soysalper/METU-EE464-TermProject/EE 464 Hardware Project Final Report.docx

# EE 464

# Hardware Project

# Final Report

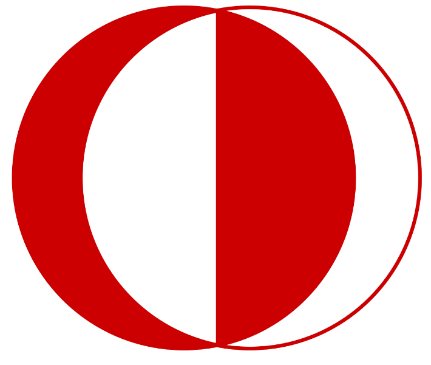
[picture p1: figure]

Team 5

Student 1 & ID: Alper Soysal & 2305324

Student 2 & ID: Hüsnü Oğuz Yorgancılar & 2305787

Student 3 & ID: Göktuğ Tonay & 2305506

# Introduction

In this report, we will explain the design procedure of the push pull converter for the METU EE 464 – Hardware Project. Basically, we will look at the circuit and magnetic design. Then, we will examine the simulation results. After that, we will talk about the implementation procedure. Finally, we will look at the test results of the implementation.

# Topology Selection

There are many topologies to design an isolated DC-DC converter such as flyback, forward, push pull etc. Each of them has some advantages and disadvantages. So, we want to select the topology as different from the other hardware project. As a result, we decided to design a “Push Pull Converter”.

Advantages

- Good transformer core utilization
- Easier to base drive (low side switching)
- Small Filter and Transformer
- Interleaved Structure

Disadvantages

- Voltage stress on the FET’s is twice the input voltage
- Asymmetric switch signals cause a flux walking in the core
- Number of the semiconductors are larger than the other topologies

# Magnetic Design

## Transformer Design

In order to determine the turn ratio of the transformer, we can look at the push pull converter voltage equation.

V_(out) =2*V_(in) *D*(N_2)/(N_1)

In the design requirements, we know that input voltage varies between the 24V and 48V. Also, push pull converter requires duty cycle which is smaller than the 0.5.

If we put a range for duty cycle such as 0.15 < D <0.3, we can find the necessary turn ratio

15=2*48*0.2*(N_2)/(N_1) =>(N_2)/(N_1)=1

Minimum number of turns can be determined as the flux density in the core cannot reach the saturation. So, minimum number of turns can be calculated as following formula.

(V_(input-max) *D_(maxi) *1/(f_s))/(2*B_(sat) *A_e)=N_1

Then, we can use the effective area of the core. Our first core decision is the TDK Electronics B66335G0000X187 magnetic core. Its effective cross-sectional area is 354 mm² .

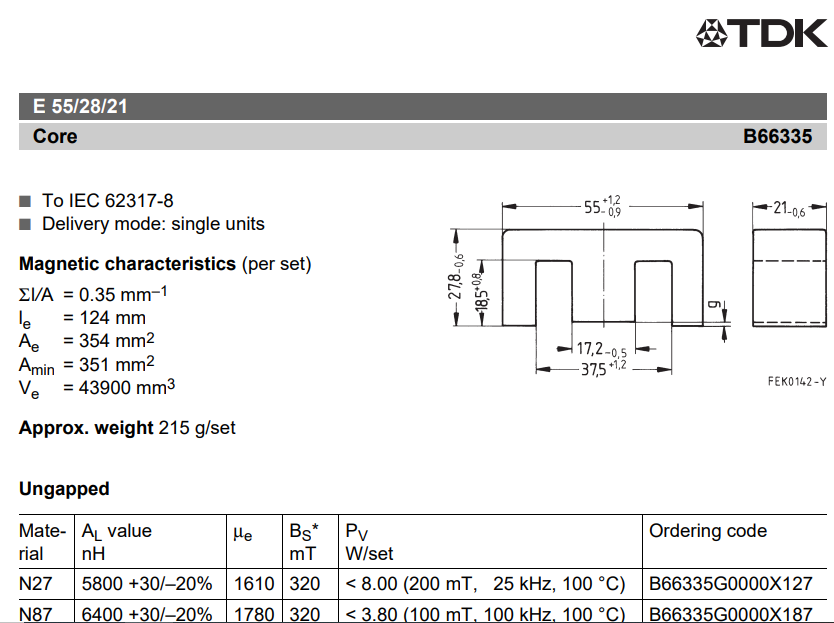
[picture p2: figure]
tablo içeren bir resim Açıklama otomatik olarak oluşturuldu
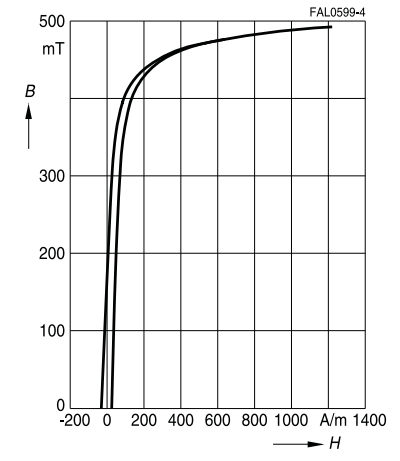
[picture p3: figure]

Maximum flux density varies depends on the material of the core. For a safety, we can select as maximum 0.2 T.

N_(1-min) =(48*0.3*1/(100k))/(2*0.2*354x10^(-6))≅1

In order to put a safety, number of turns can select as 4 turn primary and 4 turn secondary.

In the simulation, maximum current is 2.2 A for input, 3.3 A for the output. Also, our core has more window area. So, we decided to use directly a litz cable which has 3.14 mm^2 area which can carry nearly three or four times the expected currents. Then, when we calculate the fill factor, we obtained the following calculation

Fill Factor=((8+8)*3.14)/((10.15*18.5)*2)=%10

## Inductor Design

In the Push Pull topology, we need an inductor. We assumed that inductor current ripple is around %10 of the maximum output current.

Δi_L =3*0.1=0.3 A

Then, we can write the inductor voltage equation as:

V=L*(Δi)/(Δt)L=V*(Δt)/(Δi)=(((V_S *(N_S)/(N_P)-V_O )*(D/(f_s))))/(Δi)=(((48*1-15)*((0.3*2)/(100e3*2))))/0.3

=330 μH

# Simulation Results

In the simulation report, we simulated the circuit while N2/N/1=3/4. After changing that ratio to 4/4, we have updated the simulation results. Also, we have included all the nonidealities such as diode forward voltage, MOSFET RDS,ON, capacitor and inductor ESR values.

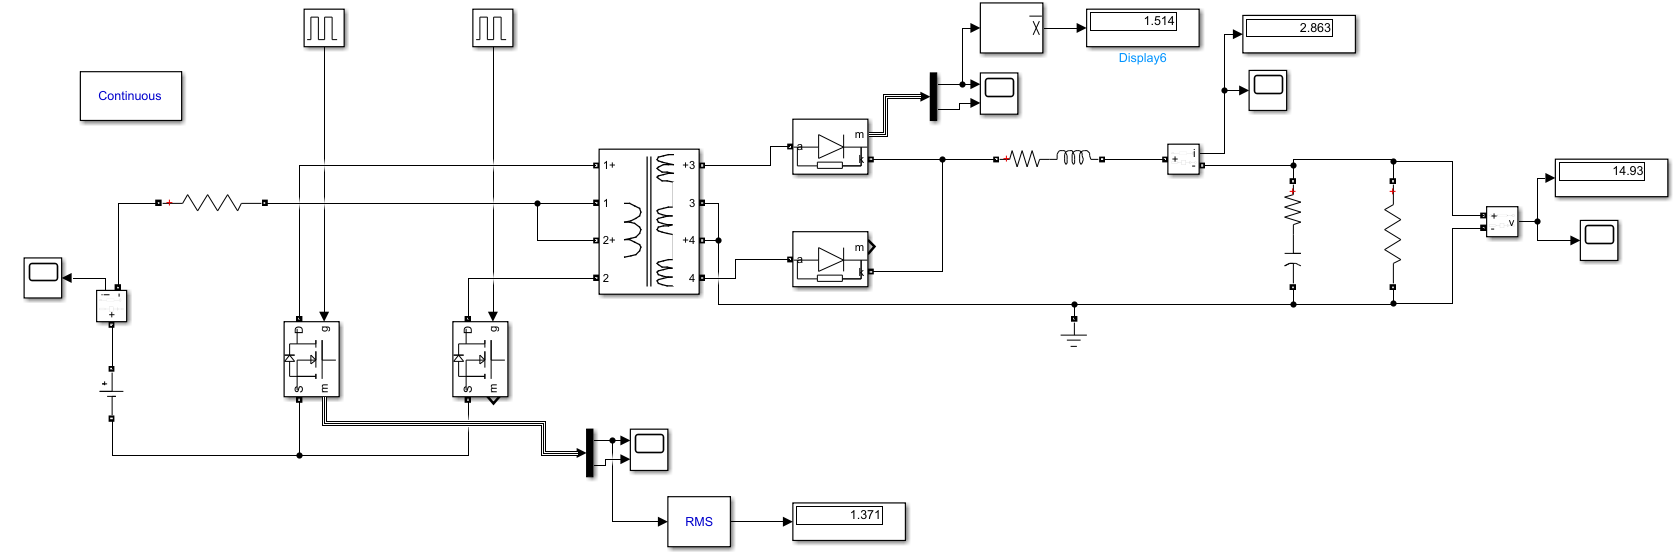
[picture p4: figure]

Figure-1: Simulation model of our circuit

When the input is 24V, with 0.44 duty cycle, simulation results including input current, output current & voltage, primary & secondary coil voltages, diode current & voltage, switch current & voltage are obtained as follows:

Figure-2: Output Voltage with 24V input

Figure-3: Output Current with 24V input

Figure-4: Switch current and voltage with 24V input

Figure-5: Diode current and voltage with 24V input

All those simulations are also done for 48V input, with a duty cycle of 0.16. Since we increased the inductance of the output inductor, we get less current ripple. On the other hand, due to the ESR of the output capacitors, we get a higher output voltage ripple around 200mV. Also, the diode maximum voltage is now doubled to 96V.

Figure-6: Output Voltage with 48V input

Figure-7: Output current with 48V input

Figure-8: Switch current and voltage with 48V input

Figure-9: Diode current and voltage with 48V input

# Component Selection

In a push-pull converter, we mainly need a controller, transistors for switching, transformer, diode for rectification and inductor for filtering. We already discussed about inductor and transformer in this report. We will start with the discussing about component selection with controller for our converter.

As already mentioned about in the topology selection part, push pull converter has some disadvantages. First and main one is, asymmetry due to manufacturing errors and tolerances, cause flux walking in the core. Flux walking can be defined as accumulation of the flux in the core due to non-zero net flux in a cycle. This non-zero net flux will be add up in the time and will cause saturation of the core. There will be constantly increasing DC component of the flux of the core. In the low frequency transformers like in the mains transformers, resistive components of the windings control this problem. However, in a high frequency transformer in our case, resistive component of the winding is not enough to solve. This means that in a realistic push-pull converter will create a non-zero net flux in the core every cycle which add up with the previous one. If we plot the flux in the core, it will look like it is walking or in a stair shape. To solve this problem, current control can be used. In current mode control, duty cycle of the switched will be controlled according to the current passing through each switch. Average or peak current can be used to control.

Due to that problem, our controller must have current mode control. With that input we searched for controllers and chose LM5030 as our controller.

LM5030:

Basic structure of the controller can be seen below.

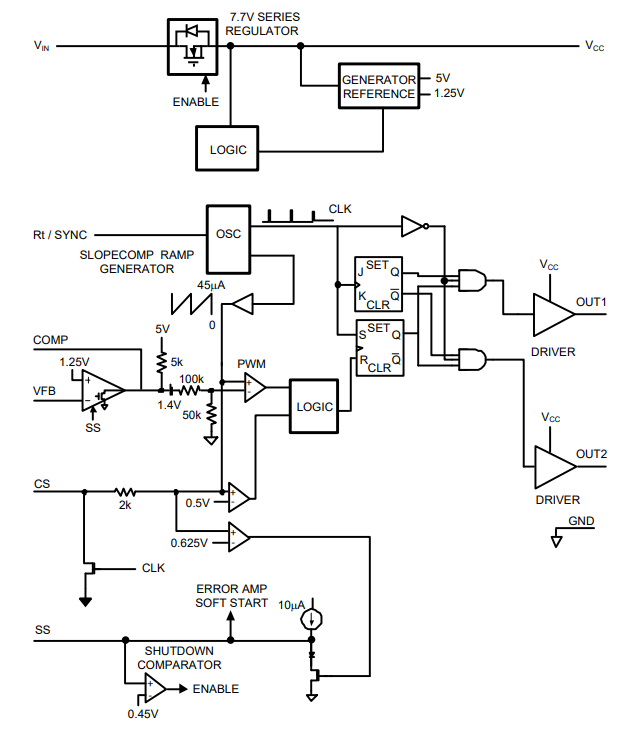
[picture p5: figure]

Figure-10: Block diagram of LM5030

Advantages:

- Can be found in the global component stocks
- All required blocks included
- Designed for isolated controller
- Vin accepts voltage up to 100V, no external regulator needed
- 1.5A gate drivers
- Slope compensation
- Good reference design and resources

Disadvantages:

- Comes in a small MSOP package, which have a very small pitch for hand manufactured PCB.

Selection of the semiconductors in a converter is quite critical. However, different from real life cost is not our main parameters in the selection. While doing the selection of the diodes and mosfets, we mainly calculated the resultant losses, effects on the efficiency and voltage/current ratings. Due to nature of the semiconductor, mainly increasing voltage rating results higher losses. Bigger or more spaced junction creates higher capacitances, so to optimize the switching and conduction losses of the mosfets, we must select the mosfet with least voltage. For that purpose we do research on suppliers site rather than manufacturers due to chip crisis. Due to lower switching loss, and acceptable conduction loss compared to other available components we selected IPP200N15N3GXKSA1 from Infineon(150V N-Channel Mosfet) as main switching element, it complies with our minimum voltage rating(input voltage*2+induced voltage on leakage= at leat 96V).

Second semiconductor to select is the diodes in the secondary side, since they will also switch in 100Khz it is important to select a diode with low switching losses. Hence, we selected Schottky diode MBR10100G from Onsemi(100V), with maximum forward voltage drop of 950mV, which creates acceptable conduction loss.

# Implementations

In the implementation phase of our project, we decided to implement the project directly on the printed circuit board. Since in a single sided PCB, we encountered some problems related the location of some signal and power traces, we designed our board in a 2 layer PCB. However, since the manufacturer is also us, we rarely use second layer of our PCB. Moreover, out controller, LM5030, comes in a very fine pitch package(MSOP10) it is hard to directly use it in a hand manufactured PCB. To reduce the risk, we order a breakout board which converts msop10 package to DIP10 package.

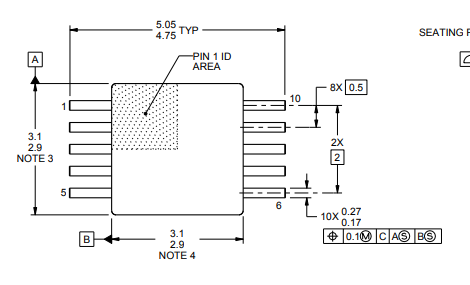
[picture p6: figure]

Figure 11: Dimensions of our controller

After the selection of implementation type and main components, we started to design our PCB in Proteus. Parts of our schematic can be seen below.

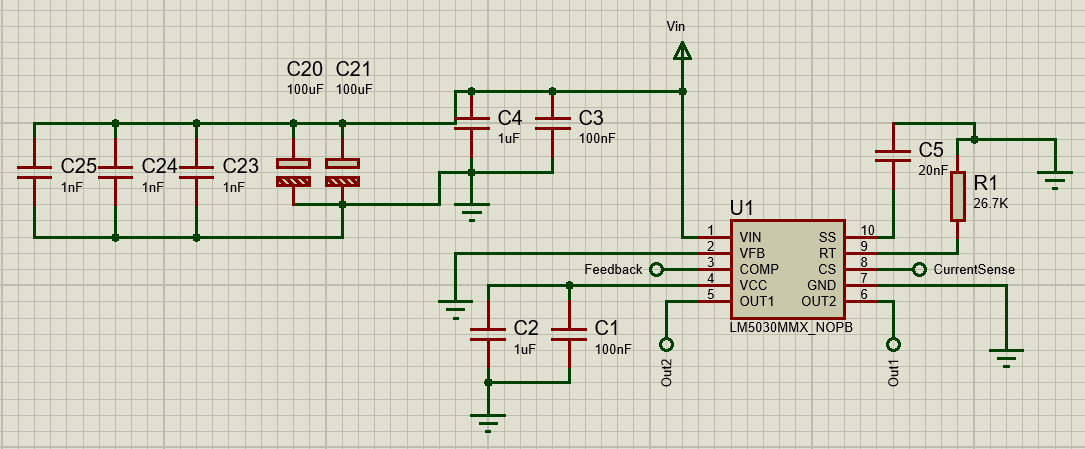
[picture p7: figure]

Figure 12: Schematic of controller

Our controller can be used in other feedback techniques, both isolated and non-isolated, however since we create the voltage feedback through optocoupler, we pulled down the input of error amplifier. In our feedback type, main components of the error amplifier is the TL431(which located in the secondary) and optocoupler. We directly connected our error path to comp line, which is originally output of the error amplifier of the controller. The second required feedback, current feedback, mainly requires feedback of the switch currents, to achieve this, source legs of the NMOS switches connected a shunt resistor.

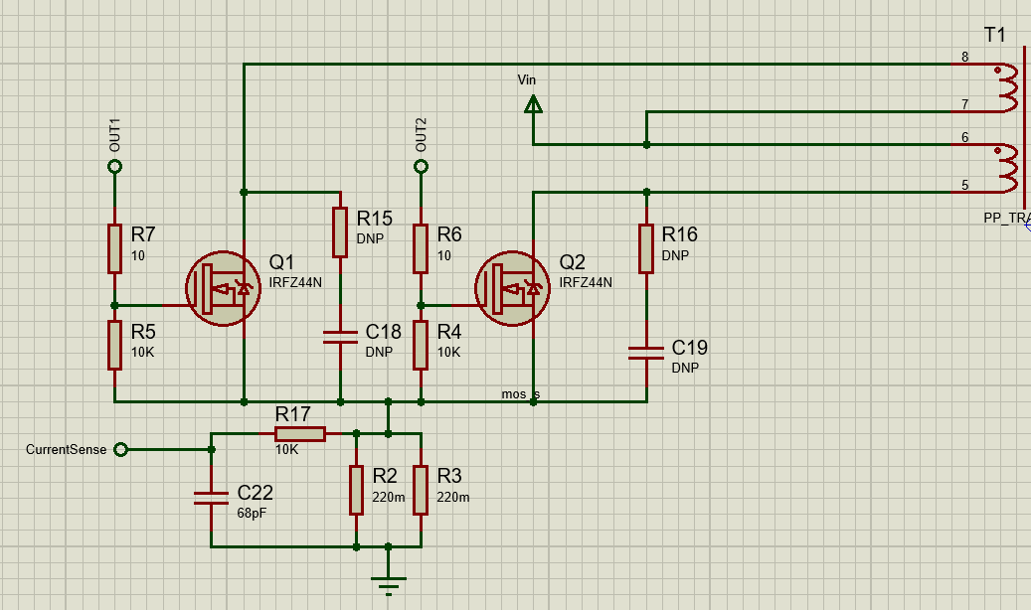
[picture p8: figure]

Figure 13: Switch part of the schematic

As can be seen above, we added a RC filter in the path of the current feedback. Corner frequency of the frequency calculated a little bit higher than the frequency of the signal to be measure. Since the snubber values is hard to decide on the schematic, we only create space for them. After the production and test final values decided as 1nF and 100Ohm, since packages of that components allow 1W of power dissipation, we doesn’t encountered any snubber problem related to heat.

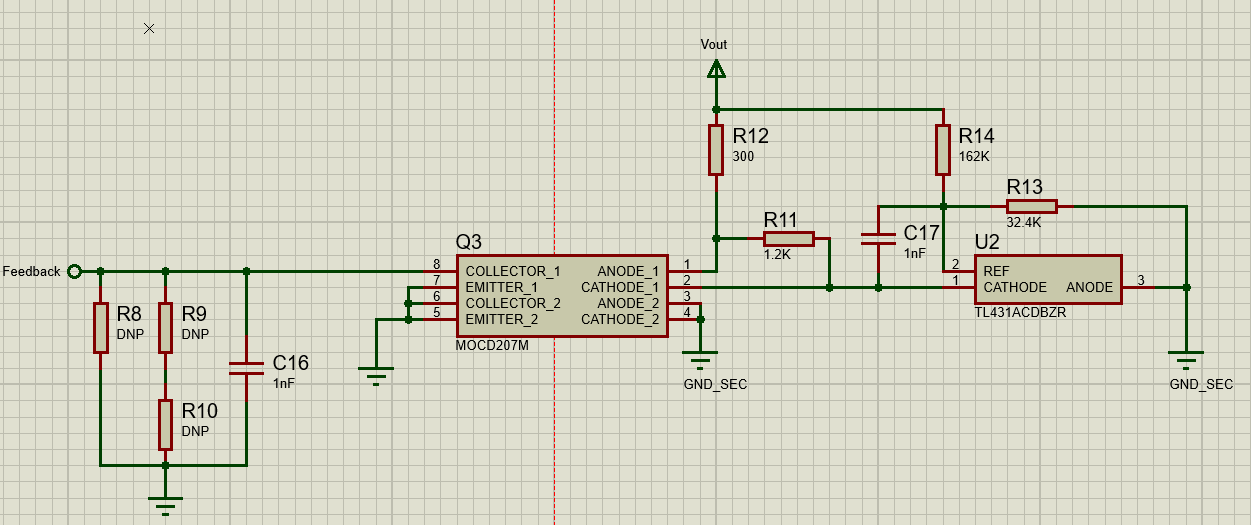
[picture p9: figure]

Figure 14: Schematic of feedback with isolation line

Due to high current transfer ratio and availability we decided to MOCD207M as optocoupler. We designed a type 2 compensation network for our circuit for best steady state and transient response. Location of pole and zero calculated by considering switching frequency, and values of passive components calculated by considering our pole and zero locations, characteristics of TL431 and our controller. We added R8, R9 and R10 if we need a locate any additional components in our circuit. With that configuration location we have open loop gain of approximately 17dB. Calculated values give us required performance in that project, hence no further improvement made in the test phase.

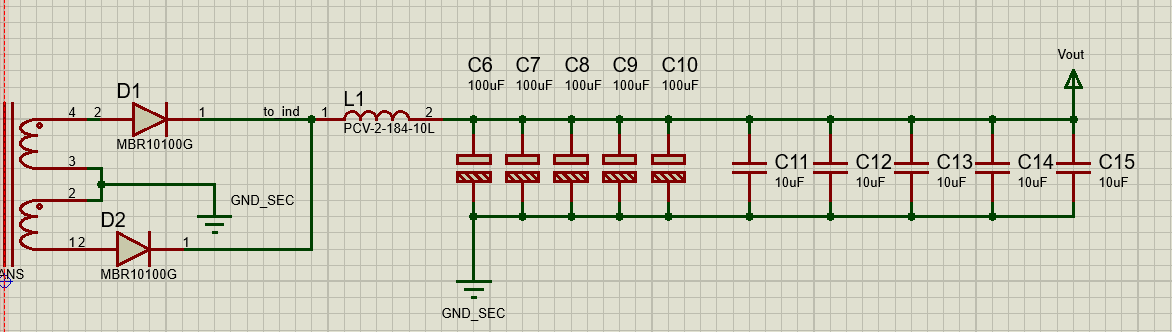
[picture p10: figure]

Figure 15: Secondary side of the project

Last part of our schematic is secondary side, which is composed of diodes, inductor and output capacitors. This part of our schematic has a lot of modification on the PCB. Firstly, we replaced our first electrolytic capacitors due to problems about their ESL and ESR with a better one. Moreover, we added some film capacitors, and increase the number of MLCC. Every ceramic capacitor at out phase works in DC bias of 15V, which reduces our capacitance value to 2.5uF for every ceramic capacitor. Last modification in that part is the snubbers of the diodes, we forgot the add snubber to the diodes. While testing the project we saw a 5Mhz signal on the corners of the diode voltage waveform, so we again add a 1nF and 100Ohm snubber to solve it. Our RC snubber network result in a overdamped response in that signal.

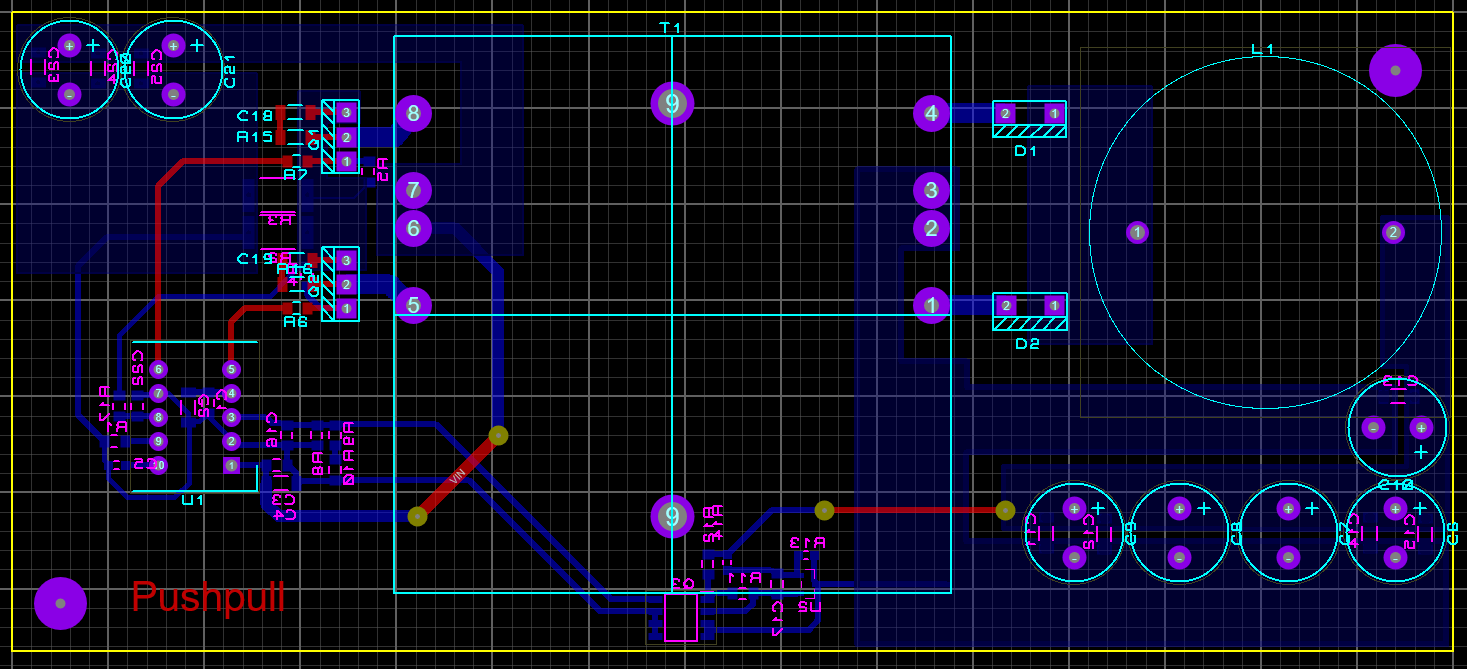
[picture p11: figure]

Figure 16: Layout of our circuit (Red: top copper, blue: bottom copper)

Some photos related to our circuit and soldering phase can be seen below.

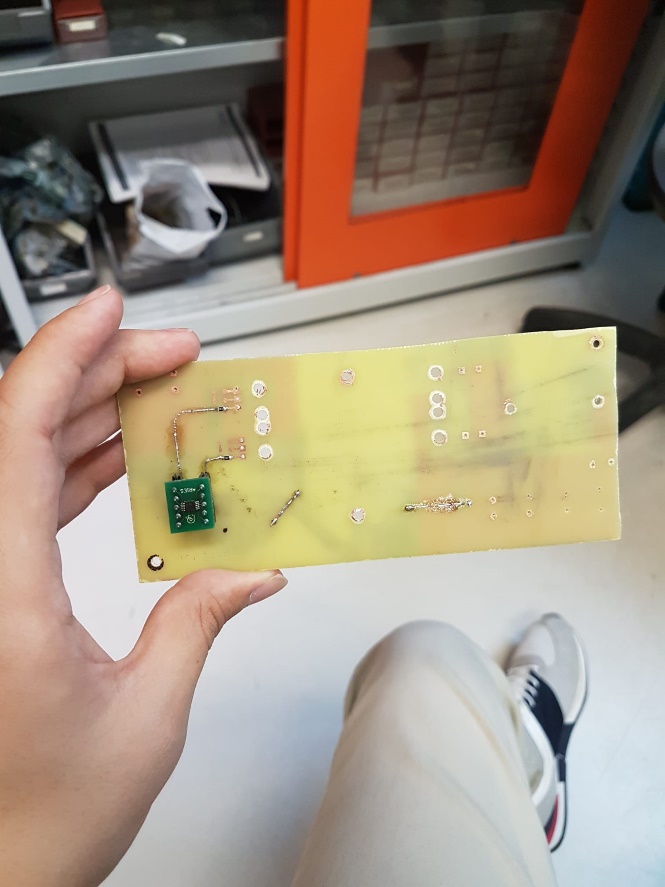
[picture p12: figure]
metin, kişi, iç mekan, el içeren bir resim Açıklama otomatik olarak oluşturuldu
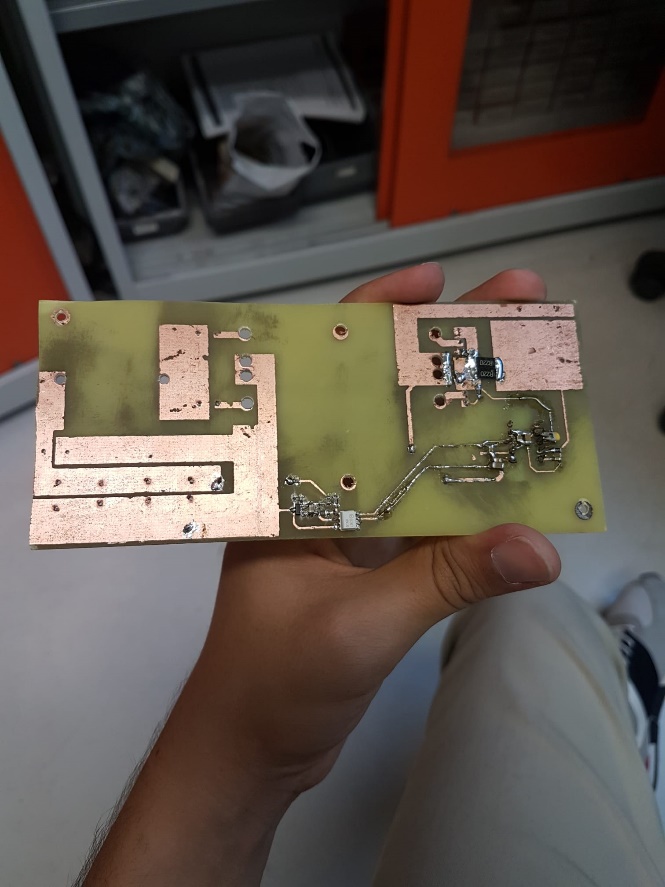
[picture p13: figure]
metin, kişi içeren bir resim Açıklama otomatik olarak oluşturuldu

Figure 17: Soldering stage

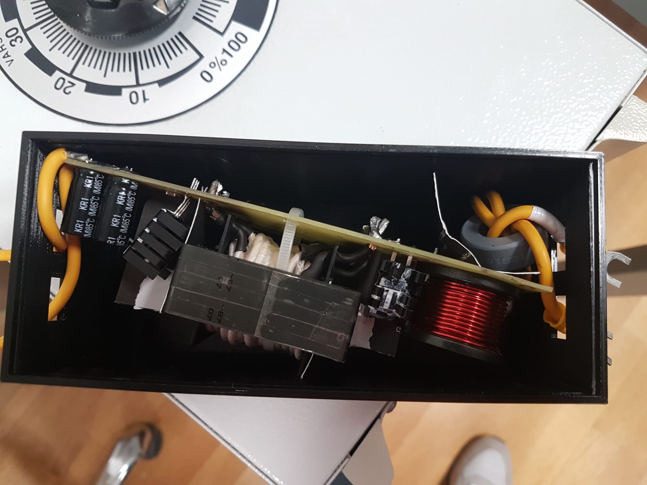
[picture p14: figure]
metin içeren bir resim Açıklama otomatik olarak oluşturuldu

Figure 18: Final product in box.

# Test Results

According to our test results, our designed converter satisfies the requirements. Our calculations about the losses are mostly comply with the implementation. Our final values are, less than 200mV output ripple, better line and load regulation than 0.5%. Our converter reaches efficiency higher than 80% with output load of higher than 15W in whole input voltage range.

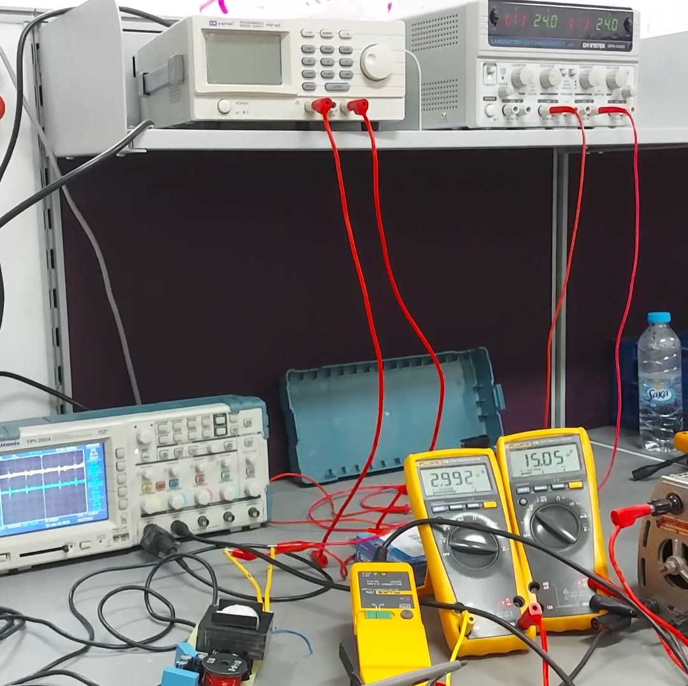
[picture p15: figure]
metin, elektronik eşyalar içeren bir resim Açıklama otomatik olarak oluşturuldu

Figure-19: 48V 3A operation

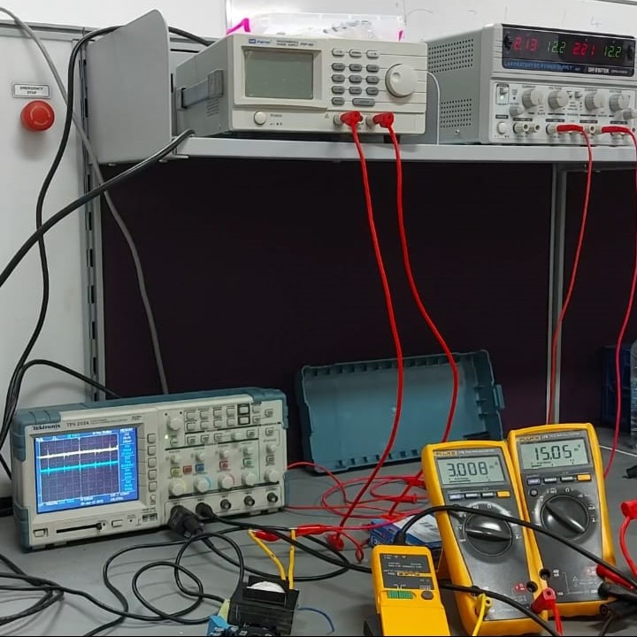
[picture p16: figure]

Figure-20: 24V 3A operation

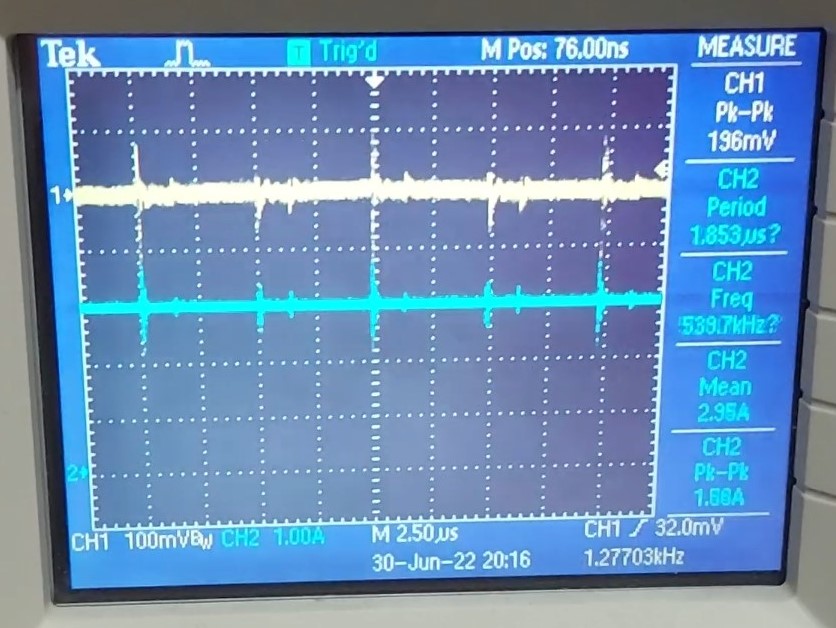
[picture p17: figure]
metin, vitrin, elektronik eşyalar içeren bir resim Açıklama otomatik olarak oluşturuldu

Figure-21: Output voltage(CH1) and current(CH2) for 24V 3A

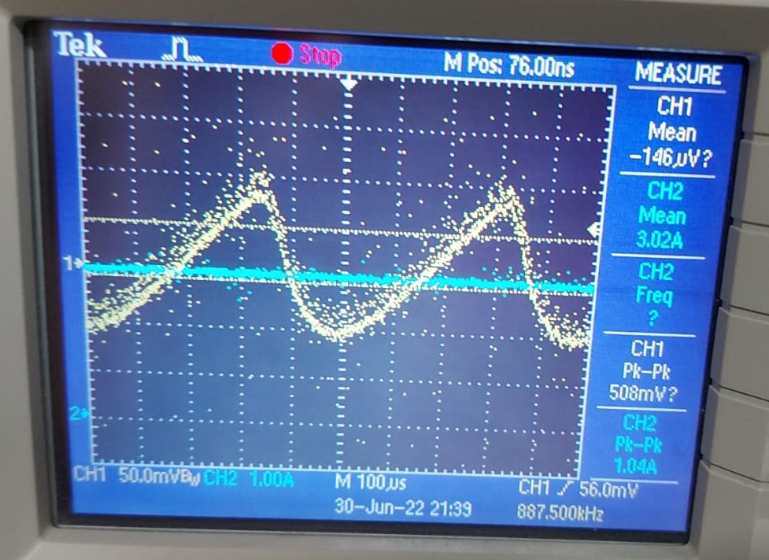
[picture p18: figure]
metin, vitrin, elektronik eşyalar içeren bir resim Açıklama otomatik olarak oluşturuldu

Figure-22: Output voltage(CH1) and current(CH2) for 48V 3A

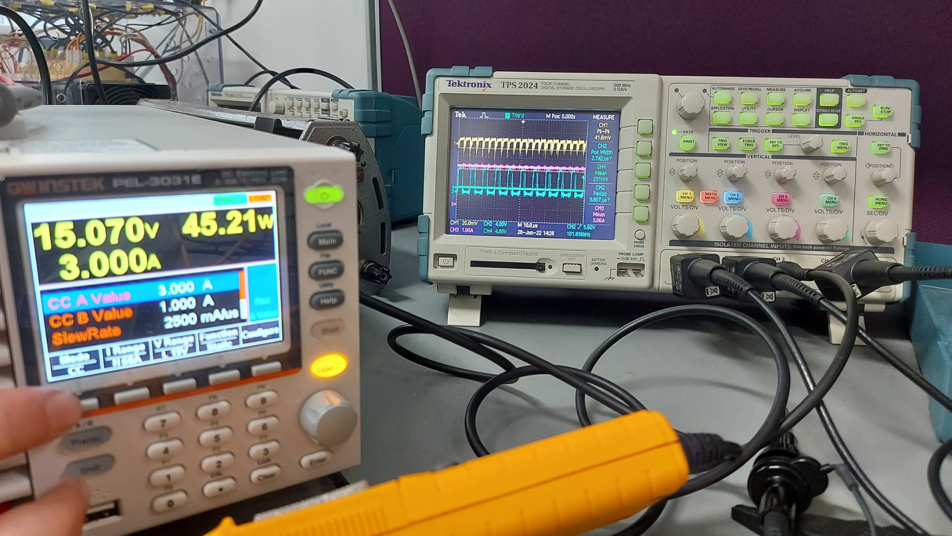
[picture p19: figure]
metin içeren bir resim Açıklama otomatik olarak oluşturuldu

Figure-23: 45W output with 24V input

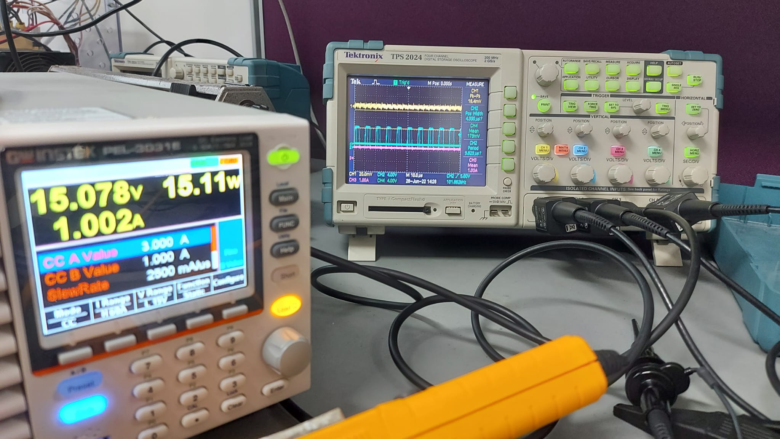
[picture p20: figure]
metin, elektronik eşyalar, kalabalık içeren bir resim Açıklama otomatik olarak oluşturuldu

Figure-24: 15W output with 24V input

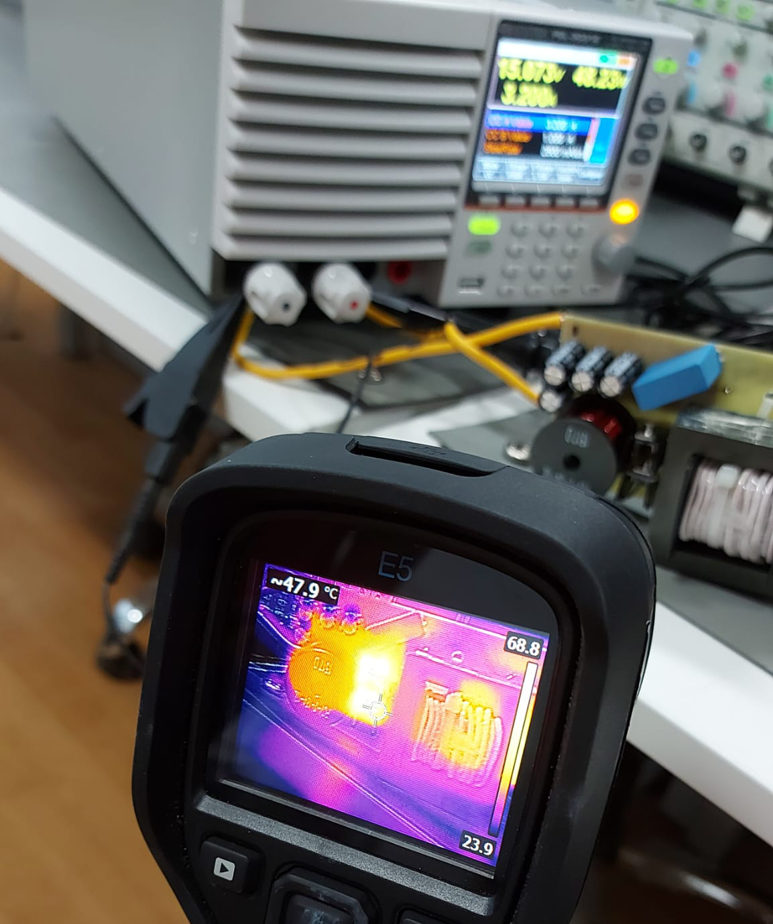
[picture p21: figure]
metin, iç mekan, kişi, yer içeren bir resim Açıklama otomatik olarak oluşturuldu

Figure-25: Diode temperature with 45W output

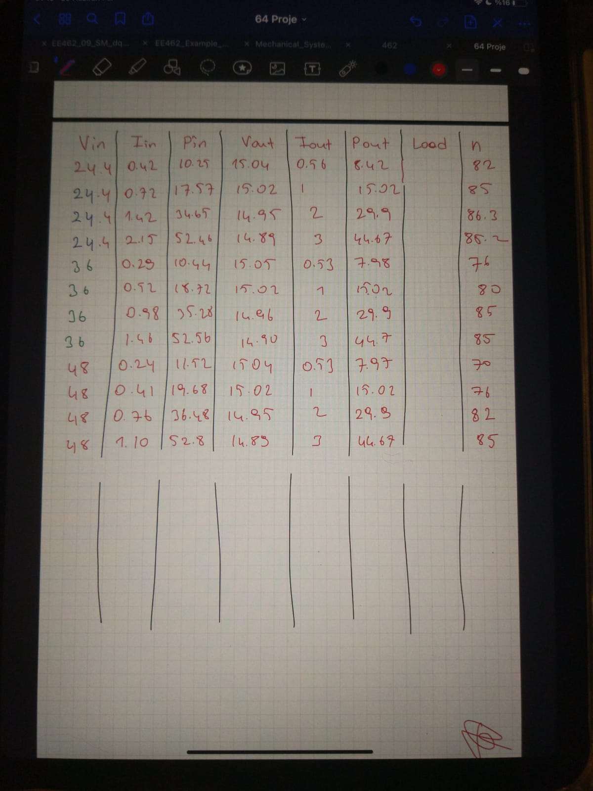
[picture p22: figure]
beyaz tahta içeren bir resim Açıklama otomatik olarak oluşturuldu

Figure 26: Efficiency values for different loading conditions(some measurement error on output voltage due to cable voltage drop)

# Cost Analysis

Components | Unit | Unit Price ($) | Total Price
Mosfet (IPP200N15N3GXKSA1) | 2 | 2.263 | 4.526
Diode (MBR10100G) | 2 | 0.66017 | 1.32034
Inductor (PCV-2-184-10) | 1 | 4.54 | 4.54
Octocoupler (MOCD207M) | 1 | 0.45974 | 0.45974
Controller (LM5030) | 1 | 1.92 | 1.92
Core (B66335G0000X187) | 2 | 3.03 | 6.06
TL431 | 1 | 0.17 | 0.17
Heatsink | 4 | 0.1 | 0.4
Capacitors | - | - | 2
Resistors | - | - | 0.1
PCB | 1 | 1.5 | 1.5
3 D Box | 1 | 5 | 5
| | | 28 $
