soysalper/METU-EE464-TermProject/Simulation Report.docx

# EE 464

# Hardware Project

# Simulation Report


Team 5

Student 1 & ID: Alper Soysal & 2305324

Student 2 & ID: Hüsnü Oğuz Yorgancılar &

Student 3 & ID: Göktuğ Tonay & 2305506

# Introduction

In this report, we will make a design decision and select a topology to produce an isolated DC-DC converter. Also, we will analyse this circuit in the simulations and obtain some results. Then, we will select some components according to simulation. Lastly, we will look at the preliminary results of transformer and inductor that we build.

# Topology Selection

There are many topologies to design an isolated DC-DC converter such as flyback, forward, push pull etc. Each of them has some advantages and disadvantages. So, we want to select the topology as different from the other hardware project. As a result, we decided to design a “Push Pull Converter”.

Advantages

- Good transformer core utilization
- Easier to base drive (low side switching)
- Small Filter and Transformer
- Interleaved Structure

Disadvantages

- Voltage stress on the FET’s is twice the input voltage
- Asymmetric switch signals cause a flux walking in the core
- Number of the semiconductors are larger than the other topologies

# Transformer Design

In order to determine the turn ratio of the transformer, we can look at the push pull converter voltage equation.

V_(out) =2*V_(in) *D*(N_2)/(N_1)

In the design requirements, we know that input voltage varies between the 24V and 48V. Also, push pull converter requires duty cycle which is smaller than the 0.5.

If we put a range for duty cycle such as 0.2 < D <0.4, we can find the necessary turn ratio

15=2*48*0.2*(N_2)/(N_1) =>(N_2)/(N_1)=0.78

To make the number of turn as integer, we can select the (N_2)/(N_1)=0.75=3/4=6/8

Minimum number of turns can be determined as the flux density in the core cannot reach the saturation. So, minimum number of turns can be calculated as following formula.

(V_(input-max) *D_(maxi) *1/(f_s))/(2*B_(sat) *A_e)=N_1

Then, we can use the effective area of the core. Our first core decision is the TDK Electronics B66335G0000X187 magnetic core. Its effective cross-sectional area is 354 mm² .


Figure-1: The properties of B66335G0000X187 magnetic core

Maximum flux density varies depends on the material of the core. For a safety, we can select as maximum 0.2 T.

N_(1-min) =(48*0.4*1/(100k))/(2*0.2*354x10^(-6))=1.356

So, number of turns 6 and 8 is sufficient.

In the simulation, maximum current is 2.2 A for input, 3.3 A for the output. Also, our core has more window area. So, we decided to use directly a litz cable which has 3 mm^2 area. Then, when we calculate the fill factor, we obtained the following calculation

Fill Factor=((8+6)*3)/((10.15*18.5)*2)=%12

# Inductor Design

# Preliminary Results

In order to verify our transformer and inductor design, we should measure the magnetizing inductance and leakage inductance of the transformer, and the inductance of the inductor. Also, primary and secondary resistances are obtained. These values are measured using LCR meter as seen in Figure-2&3. The magnetizing inductance seen from primary is 103.3µH, the leakage inductance is 3.83µH, and resistance is 1.02Ω. In addition, the inductance of the output inductor is measured as 43µH with an ESR of 245mΩ as seen in Figure-4.

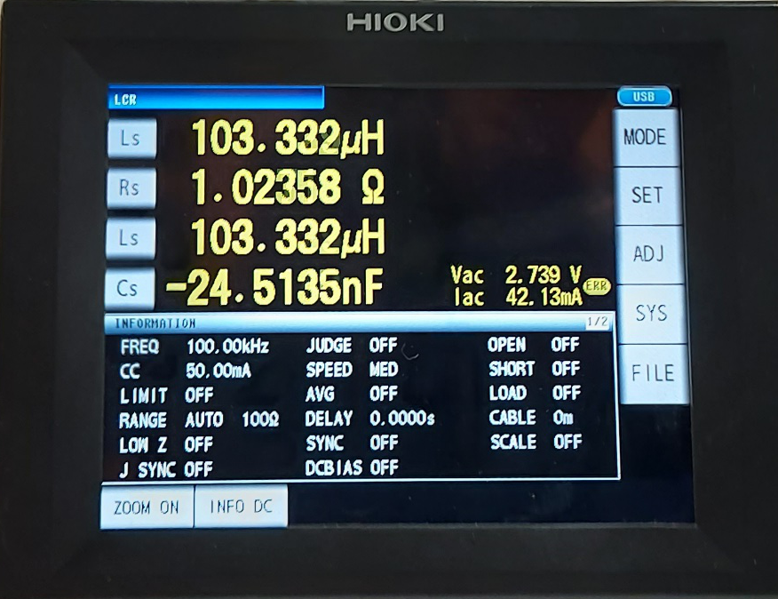
[picture p23: figure]

Figure-2: Magnetizing inductance and primary resistance

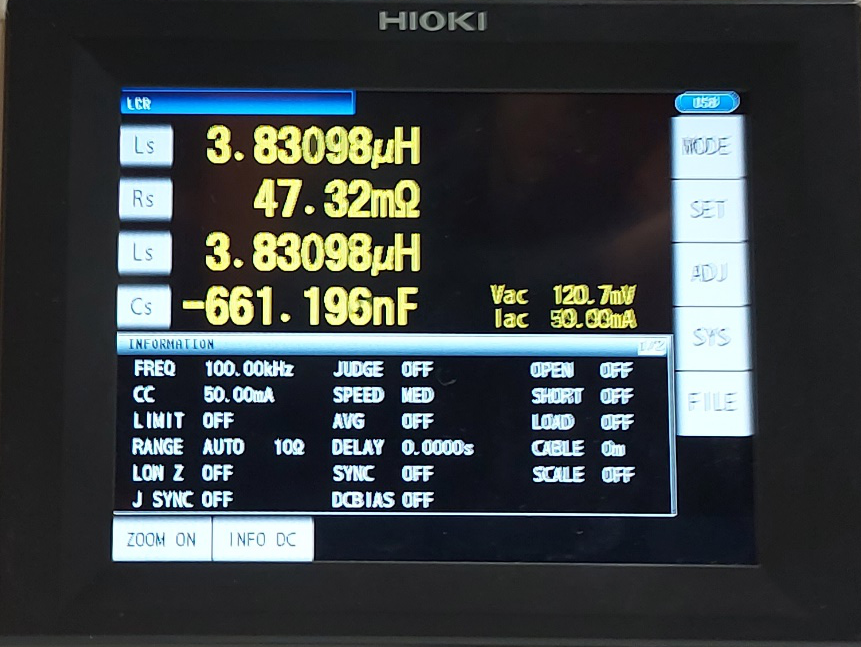
[picture p24: figure]
metin, iç mekan içeren bir resim Açıklama otomatik olarak oluşturuldu

Figure-3: Leakage inductance,

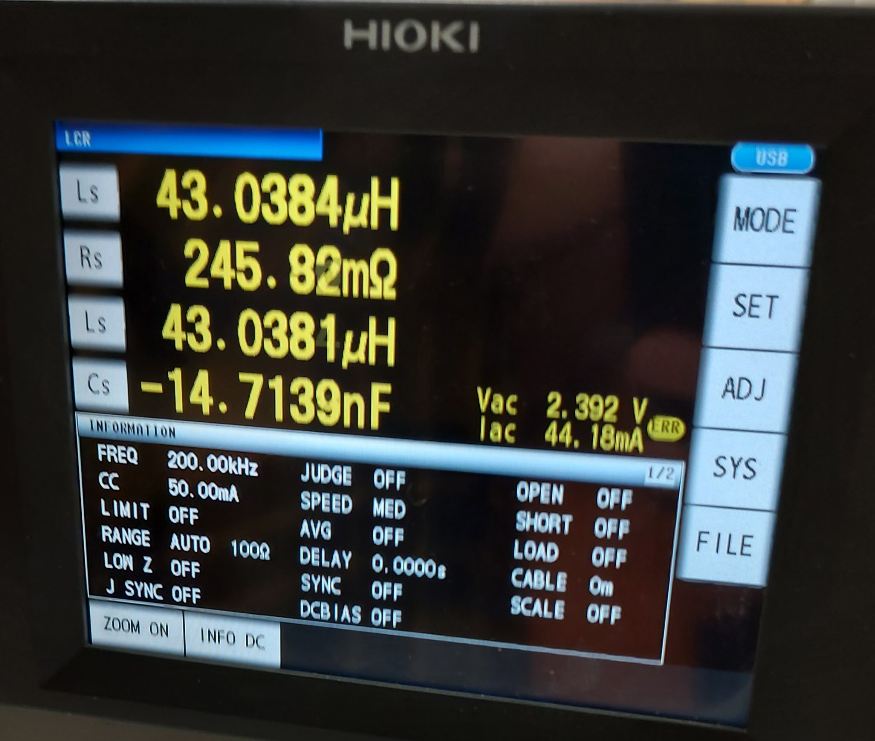
[picture p25: figure]
metin, iç mekan, elektronik eşyalar içeren bir resim Açıklama otomatik olarak oluşturuldu

Figure-4: Inductance of output inductor

As can be seen from the figures above, the inductance values for both inductor and transformer is satisfies our requirements. However, the resistance values for the transformer is quite high, this value is actually wrong. Since we don’t have a solder pot at the moment of measurement, we couldn’t connect the measuring probes to all conductors. However, for the inductor, we used pre-soldered litz cables and the resistance value is true. At the final circuit, we will use solder pot for the end part of the litz wires.

# Simulation Results

First, we have made a simulation based on our calculations. Then, we have updated the simulation results according to the measurements we made. When the input is 24V, with 0.44 duty cycle, simulation results including input current, output current & voltage, primary & secondary coil voltages, diode current & voltage, switch current & voltage are obtained as follows:

Figure-5: Output Voltage with 24V input

Figure-6: Output Current with 24V input

Figure-7: Input Current with 24V input

Figure-8: Switch Voltage with 24V input

Figure-9: Switch Current with 24V input

Figure-10: Primary coil voltage with 24V input

Figure-11: Secondary coil voltage with 24V input

Figure-12: Diode voltage with 24V input

Figure-13: Diode current with 24V input

All those simulations are also done for 48V input, with a duty cycle of 0.22.

Figure-14: Output Voltage with 48V input

Figure-15: Output current with 48V input

Figure-16: Input current with 48V input

Figure-17: Switch voltage with 48V input

Figure-18: Switch current with 48V input

Figure-19: Primary voltage with 48V input

Figure-20: Secondary voltage with 48V input

Figure-21: Diode voltage with 48V input

Figure-22: Diode current with 48V input

# Component Selection

In a push-pull converter, we mainly need a controller, transistors for switching, transformer, diode for rectification and inductor for filtering. We already discussed about inductor and transformer in this report. We will start with the discussing about component selection with controller for our converter.

As already mentioned about in the topology selection part, push pull converter has some disadvantages. First and main one is, asymmetry due to manufacturing errors and tolerances, cause flux walking in the core. Flux walking can be defined as accumulation of the flux in the core due to non-zero net flux in a cycle. This non-zero net flux will be add up in the time and will cause saturation of the core. There will be constantly increasing DC component of the flux of the core. In the low frequency transformers like in the mains transformers, resistive components of the windings control this problem. However, in a high frequency transformer in our case, resistive component of the winding is not enough to solve. This means that in a realistic push-pull converter will create a non-zero net flux in the core every cycle which add up with the previous one. If we plot the flux in the core, it will look like it is walking or in a stair shape. To solve this problem, current control can be used. In current mode control, duty cycle of the switched will be controlled according to the current passing through each switch. Average or peak current can be used to control.

Due to that problem, our controller must have current mode control. With that input we searched for controllers and find two options.

1. UC3846N:

Basic structure of this controller can be seen below.

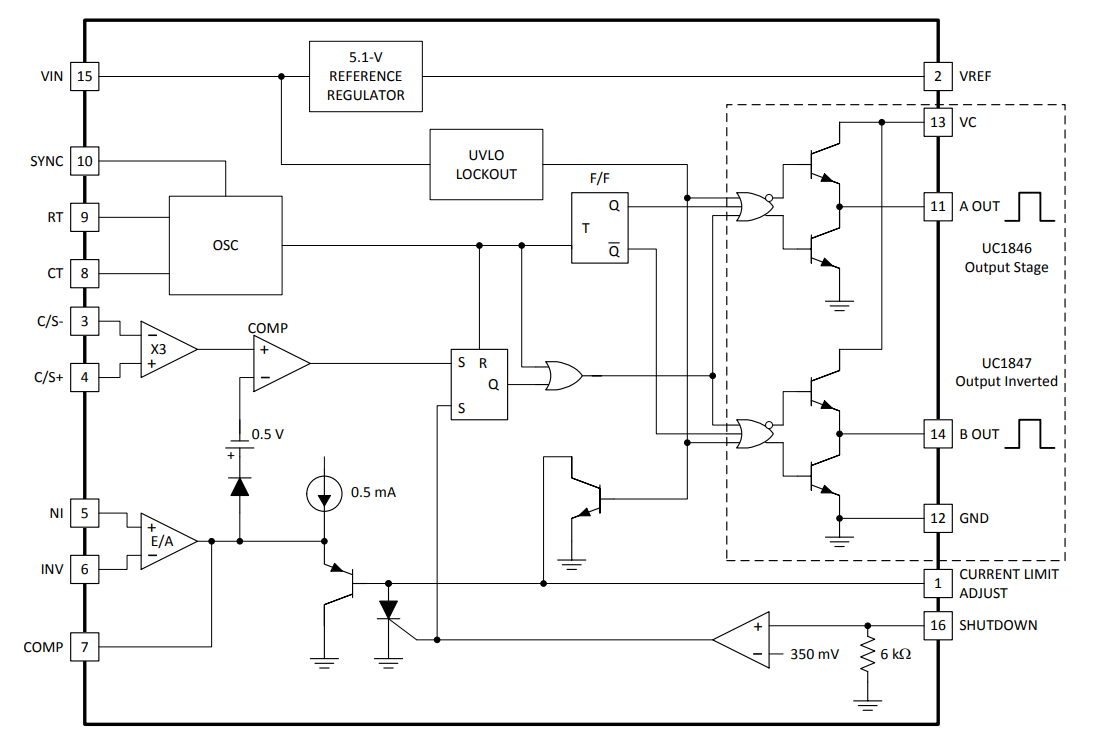
[picture p26: figure]

Figure-23: Block diagram of UC3846

Advantages:

- Easily available in Turkey
- All required blocks for control and drive the low side switches are included
- DIP package, easily used in the hand manufactured PCB
- Differential Current sense reduces the common mode noise in the sense line

Disadvantages:

- Maximum voltage in the Vin is limited with 40V requires external regulators for working above 40V.
- 500mA sink/source gate drivers can be problematic for 100kHz operation.
- Optic isolation will modify the control loop.
2. LM5030:

Basic structure of the controller can be seen below.


Figure-24: Block diagram of LM5030

Advantages:

- Can be found in the global component stocks
- All required blocks included
- Designed for isolated controller
- Vin accepts voltage up to 100V, no external regulator needed
- 1.5A gate drivers
- Slope compensation
- Good reference design and resources

Disadvantages:

- Comes in a small MSOP package, which have a very small pitch for hand manufactured PCB.

After the selection of the controller, second part to select is switches. Theoretically, maximum voltage seen by the switches in push pull converter is twice of the input voltage. However, due to leakage inductance, parasitic inductance this voltage will be higher. When a switch turns off, the energy stored in those inductances will flow through the switch. This energy will be clamped in the snubbers, however selecting the damping ratio of the snubber circuit bigger or equal to 1 is not practical. The damping ratio of the snubber adjusted so that peak of the voltage will not damage the switches. This means that switches should have maximum voltage higher than twice of the input voltage. For our application maximum voltage input is equal to 48V. This means that, we need switches which can handle more than 96V.

Second thing to consider in switch selection is, type of switch. For this kind of relatively low voltage, low power converter MOSFET switches can be a good selection. Since the current passing through the switch is low, the conduction loss will be lower with MOSFET, moreover they can be easily found in that voltages for cheap prices. Moreover, MOSFETs can be safely used in 100kHz.

Up to that point we discussed about the type and voltage rating of the switch, however current rating is another important parameter for the selection of the switch. For our converter maximum mean input current is equal to 1.875A(Assumed 100% efficiency ideal converter). This current value is really small and if we make the design for a industrial application will certainly used in the selection in the switches, however most of the power mosfets which can be easily accessible have higher current rating. Hence, current rating will not be our main parameter, easiness of the mounting, soldering and supply will have higher importance than the current rating. With that informations we can look for the N-channel MOSFETs.

For our converter we selected 3 different mosfet, ratings of that switches can be seen below.

Manufacturer Code | Manufacturer | Maximum Drain to source voltage | Maximum Drain current | Maximum Rds(ON) | Typical Rise Time | Typical Fall time | Package
SUP90140E-GE3 | Vishay Siliconix | 200V | 90A | 17mΩ | 112nS | 80nS | TO-220
SI7430DP-T1-GE3 | Vishay Siliconix | 150V | 26A | 36mΩ | 12nS | 7nS | PowerPAK SO-8
IXTP80N12T2 | IXYS | 120V | 80A | 17mΩ | 14nS | 28nS | TO-220

Table-1: Ratings of switches

Last component to select is diode, diodes in our circuit placed in the secondary, between inductor and transformer (other placing options are available). We need two diodes, and dual package diodes can be good option due to low current. For the selection of the diode, we look for available components and list them below. Since every diode operates in 100kHz, diode must be selected carefully, otherwise we will face with quite high losses. Due to low voltage, Schottky diodes with suitable voltage and current rating will be good option.

Manufacturer Code | Manufacturer | Max reverse voltage | Avg. Continuous Current | Forward Voltage | Configuration | Package
STPS8L30B-TR | STMicroelectronics | 30V | 8A | 490mV | Single | TO-252
MBRB4030T4G | onsemi | 30V | 40A | 550mV | Single | TO-263
SK1040D1 | Diotec Semiconductor | 40V | 10A | 550mV | Single | TO-252
V30100S-E3/4W | Vishay General Semiconductor - Diodes Division | 100V | 30A | 910mV | Dual | TO-220

Table-2: Ratings of diodes

Final decision of the components will be made according to the simulations and loss calculations. According to the selections, printed circuit board will be designed.
