soysalper/METU-EE464-TermProject/Magnetic Design.xlsx

Core Parameters
Product: | B66335G0000X187
Material | N89
Effective Core Area (Ae) (mm^2) | 354 | Minimum Primary Turns | 1.061016949 | Multiplacation | Primary Turns | 8
Maximum Magnetic Flux Density (Bmax) | 0.2 | Secodary Turns | 1.061016949 | 7.54 | Secondary Turns | 8
Window Area(mm^2) | 375.55
B | 37.50 | Fill Factor | 0.1278125416
E | 17.2
D | 18.5
Controller Parameters
Switching Frequency (kHz) | 100 | Output Voltage (Vmax) | 15.072
Duty Cycle Max | 0.313 | Output Voltage (Vmin) | 15.024
Duty Cycle Min | 0.157
Project Requirements
Maximum Input Voltage (Vmax) | 48
Minimum Output Voltage (Vmin) | 24
Output Voltage (Vout) | 15
Transformer Parameters
Turns Ratio (N2/N1) | 1
Wire Parameters
Area (mm^2) | 3.00
Number of paralell | 1
