soysalper/METU-EE464-TermProject/Test Results.docx

# Test Results

metin, elektronik eşyalar içeren bir resim Açıklama otomatik olarak oluşturuldu

Figure-1: 48V 3A operation


Figure-2: 24V 3A operation

metin, vitrin, elektronik eşyalar içeren bir resim Açıklama otomatik olarak oluşturuldu

Figure-3: Output voltage(CH1) and current(CH2) for 24V 3A

metin, vitrin, elektronik eşyalar içeren bir resim Açıklama otomatik olarak oluşturuldu

Figure-4: Output voltage(CH1) and current(CH2) for 48V 3A

metin içeren bir resim Açıklama otomatik olarak oluşturuldu

Figure-5: 45W output with 24V input

metin, elektronik eşyalar, kalabalık içeren bir resim Açıklama otomatik olarak oluşturuldu

Figure-6: 15W output with 24V input

metin, iç mekan, kişi, yer içeren bir resim Açıklama otomatik olarak oluşturuldu

Figure-6: Diode temperature with 45W output
