soysalper/METU-EE464-TermProject/pcb/pp_bottom.PDF

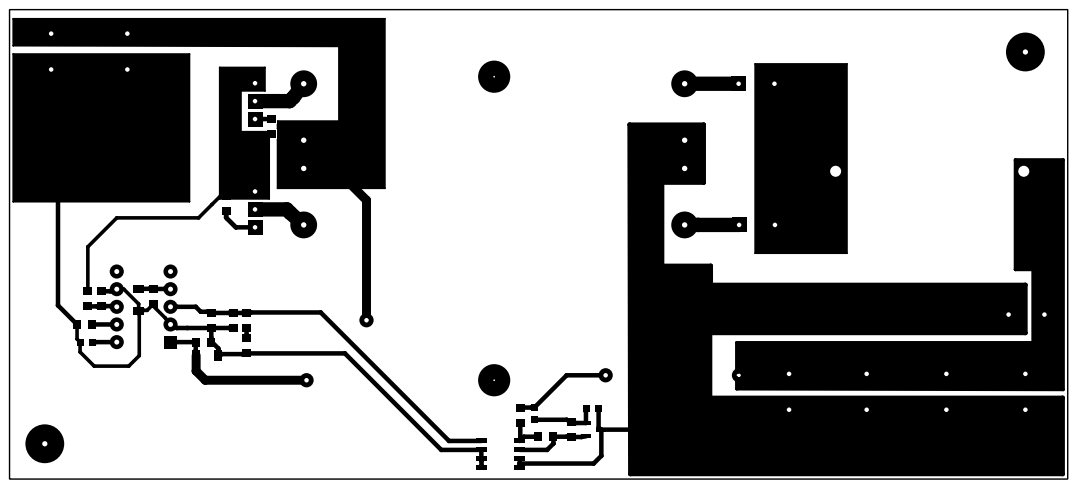
[picture p27: page 1]
