soysalper/METU-EE464-TermProject/pcb/pp_top.PDF

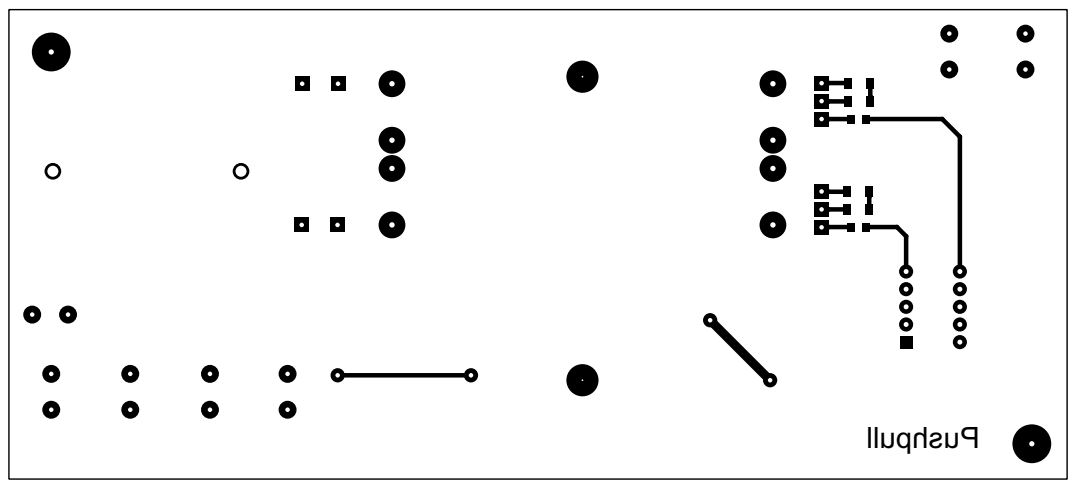
[picture p28: page 1]
