soysalper/METU-EE464-TermProject/pcb/pushpull-seperate.PDF

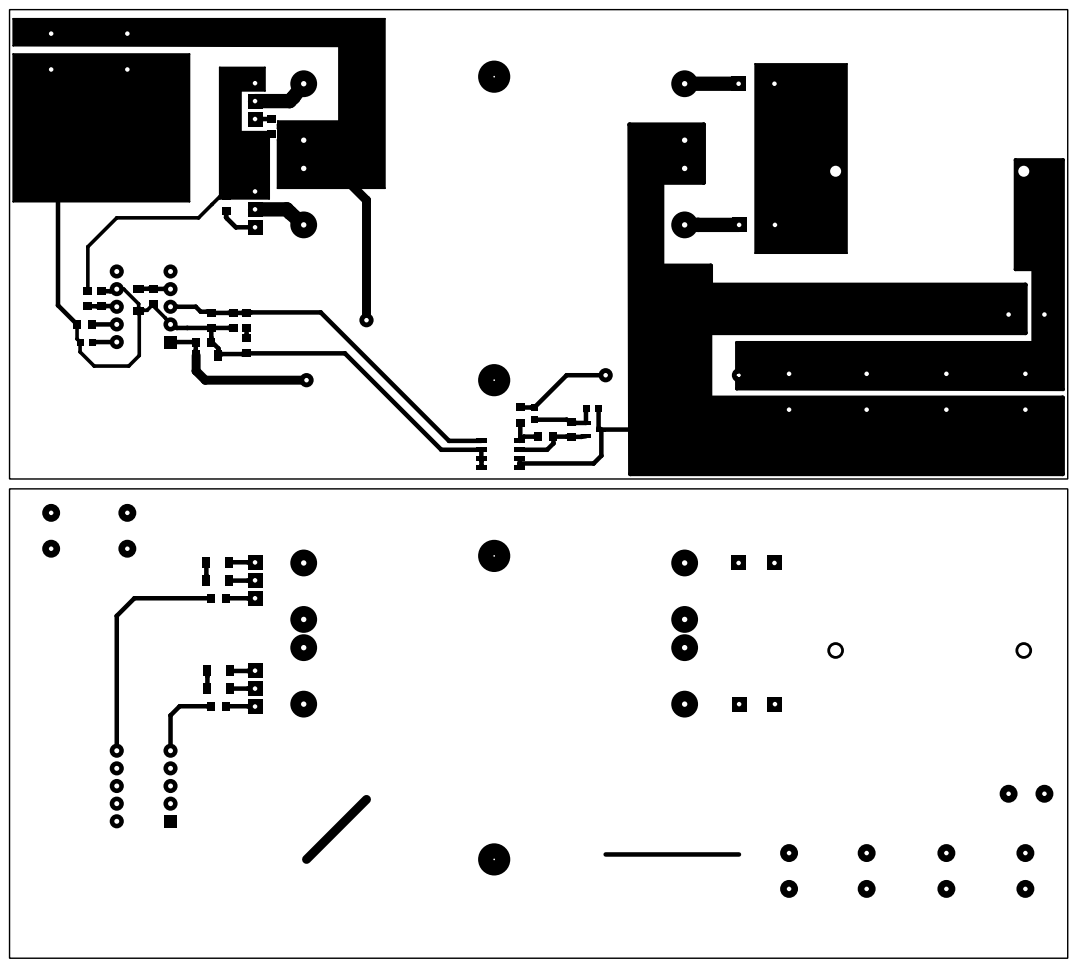
[picture p29: page 1]
