soysalper/METU-EE464-TermProject/pcb/pushpull.PDF

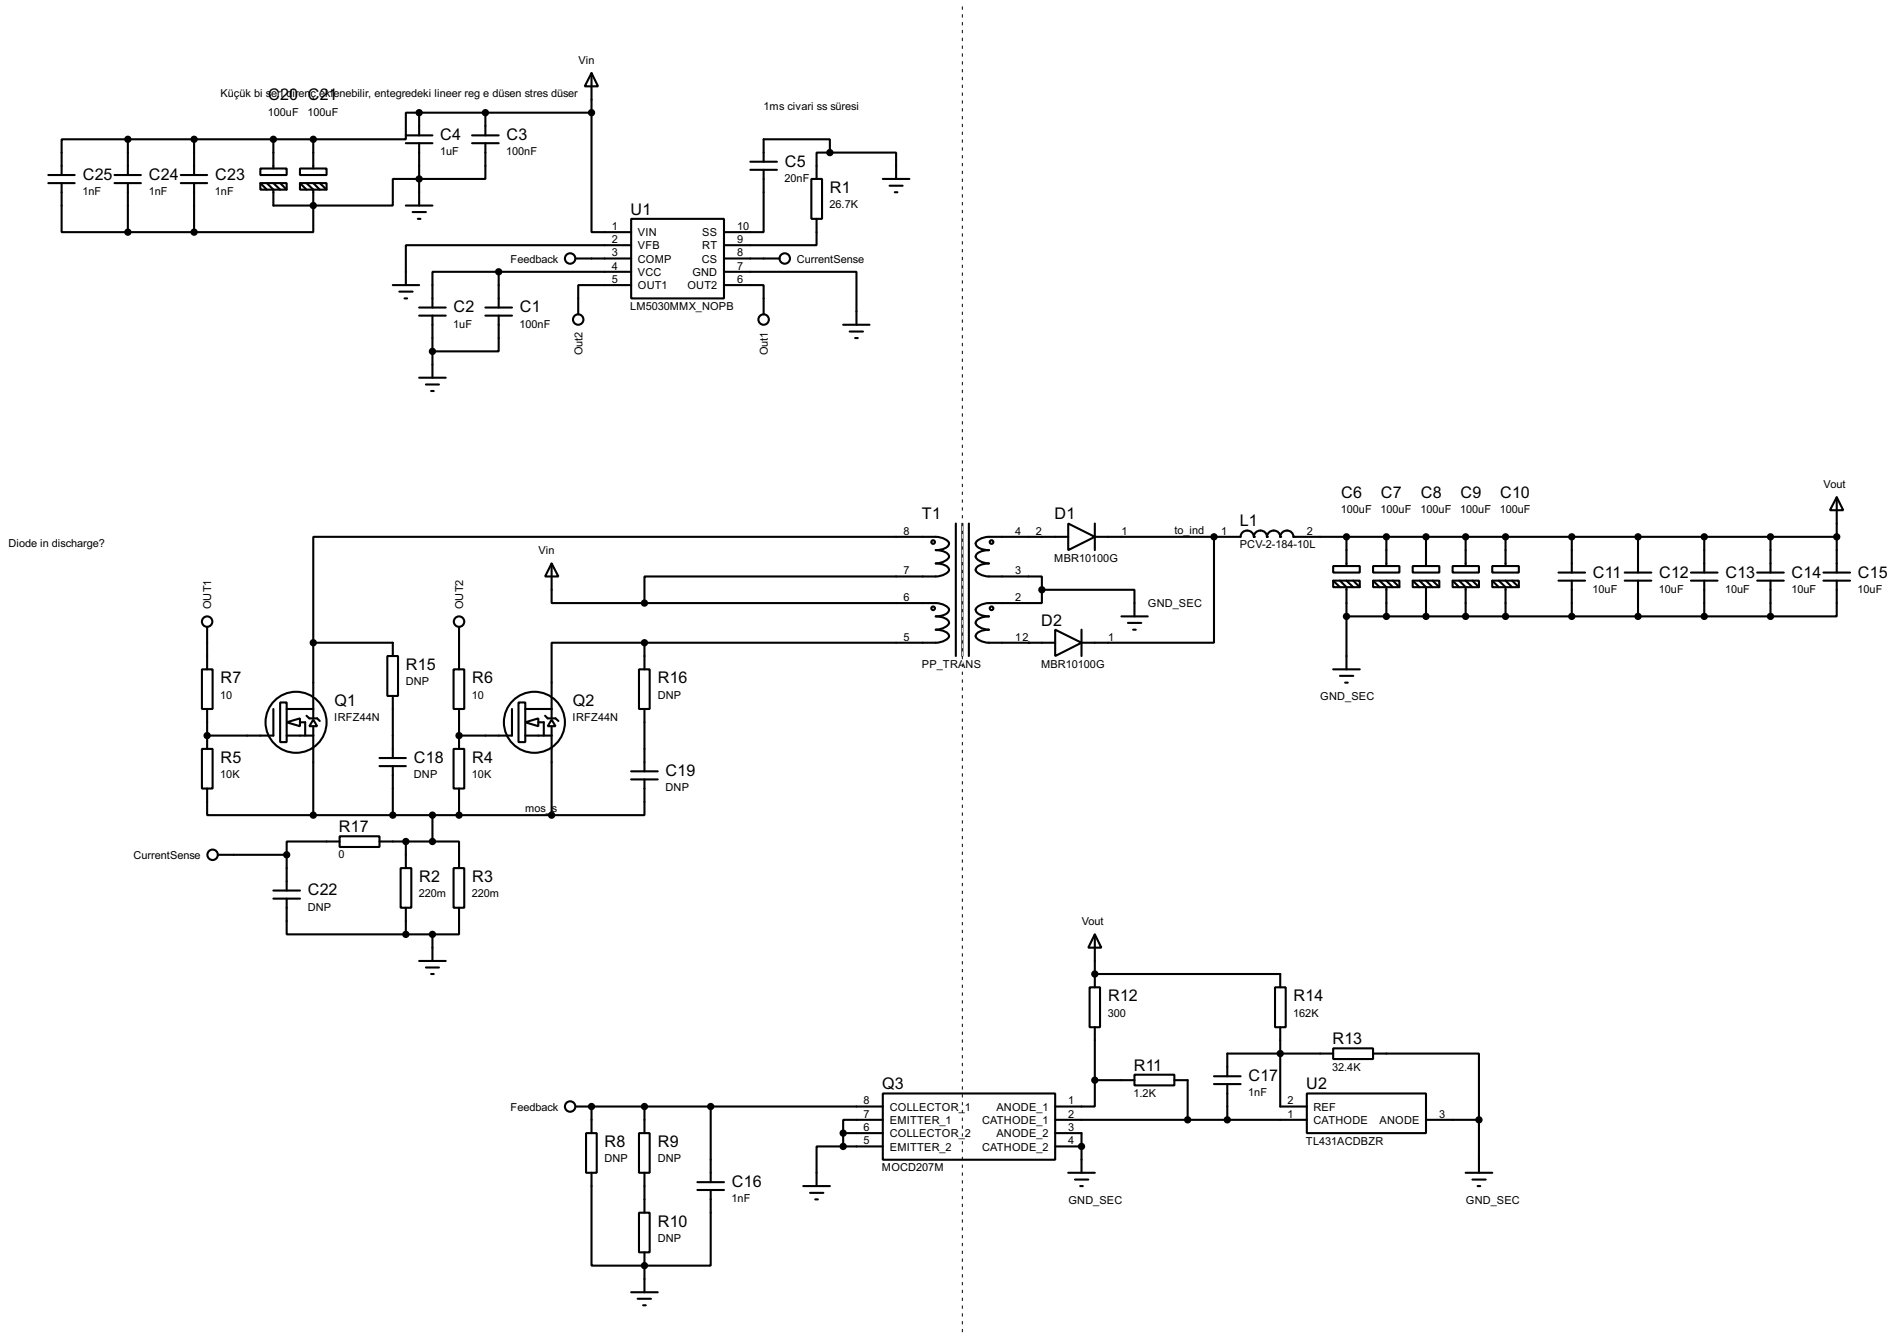
[picture p30: page 1]

Küçük bi seri direnç eklenebilir, entegredeki lineer reg e düsen stres düser
