soysalper/METU-EE464-TermProject/(list of files, drawings)

Other design files:
pcb/pushpull-seperate.pdsprj
pcb/pushpull.pdsprj
