soysalper/METU-EE464-TermProject/(commit log)

2022-04-22 Magnetic Design is added.
    [Magnetic Design.xlsx]
2022-05-14 Magnetic Design is changed.
    [Magnetic Design.xlsx]
2022-05-15 Switch selection added
2022-07-02 Duty cycle and windings are updated
    [Magnetic Design.xlsx]
2022-07-02 Create Magnetic Design.docx
